lorenzoireyes-dot/Senior-Design-1-Washer-Mover/milestone_01_sensor_actuator/reports/README.md

# Milestone 01 Report

[View the original Group 18 Milestone 01 PDF](Milestone1_Group18%20(1).pdf).

The report documents the Arduino Mega and Simulink sensor and actuator experiments, measured signals, wiring and hardware images, and a SolidWorks design exercise. Figures are embedded in the report.
