lorenzoireyes-dot/Senior-Design-1-Washer-Mover/milestone_01_sensor_actuator/cad_documents/README.md

# Milestone 01 CAD Documentation

The milestone includes a SolidWorks golf ball shaped design with a debossed team number. Its image is included in the [original Milestone 01 report](../reports/Milestone1_Group18%20(1).pdf).

No standalone SolidWorks part or drawing has been uploaded to this directory. The report remains the available design evidence.
