lorenzoireyes-dot/Senior-Design-1-Washer-Mover/milestone_02_computer_vision/cad_documents/README.md

# Milestone 02 CAD Files

- [QuarterInchGameBoard.dwg](QuarterInchGameBoard.dwg): Game board drawing in DWG format.
- [QuarterInchGameBoard.stl](QuarterInchGameBoard.stl): Exported three dimensional geometry suitable for viewing in an STL compatible application.

These are uploaded design artifacts. Their presence does not establish that the game board has been fabricated or mechanically validated.
