lorenzoireyes-dot/Senior-Design-1-Washer-Mover/milestone_02_computer_vision/pictures/README.md

# Pictures

Upload photographs, screenshots, circuit images, plots, and other visual evidence for this milestone here. The original milestone report may also contain embedded figures.
