lorenzoireyes-dot/Senior-Design-1-Washer-Mover/milestone_01_sensor_actuator/reports/Milestone1_Group18 (1).pdf

# Milestone 1

# ECE 4950 Group 18

9/18/2026
Aden Casselman, Elijah Jarrett, Lorenzo Reyes,

# Skyler Beck, Tyler Burton

Executive Summary
Milestone 1 required our group to use MATLAB and Simulink with an Arduino controller, a potentiometer, and a servo motor to complete three tests involving sensor input and actuator control. The first test demonstrated the ability to receive an analog signal from the potentiometer and display the measured values as both numerical data and a plot in Simulink. The second test demonstrated our ability to turn the servo motor directly through commands issued in Simulink. The third test combined the sensor and actuator by using the potentiometer value to control the servo motor. When the potentiometer signal reached a specified threshold, the system changed the operating state of the servo motor. The threshold was adjustable so that the response of the system could be modified as needed.
In addition to the sensor and actuator testing, our group designed a small three-dimensional object for rapid prototyping. The part included our team number, Group 18, either embossed or debossed into the design and was designed to fit within the parameters: 4”x2”x1” (LxWxD). SolidWorks was used to create a three-dimensional model. Together, these activities introduced the group to sensor data acquisition, real time control using MATLAB and Simulink, Arduino hardware interfacing, and three-dimensional modeling for engineering applications.


Materials and Methods of the Sensor/Actuator Demonstration
Equipment and Software
Item | Manufacturer/ Model Version/ Rating | Purpose
Software | MATLAB/ Simulink | 2026a | Modeling data display and control
Micro Controller | Arduino Mega | 2560 | Sensor and actuator interface
Potentiometer | B103 | | Analog input sensor
Servo motor | MG92B | | Actuator
Hardware Configuration
To begin Lab 1, the Arduino Mega was connected to the potentiometer and servo motor using jumper wires and a breadboard, as shown in Figure 1. The potentiometer was connected to the 3.3 V supply, analog input A4, and ground. The servo motor was connected to the 5.5 V supply, digital PWM pin D2, and ground. All required power and ground connections were provided by the Arduino Mega.

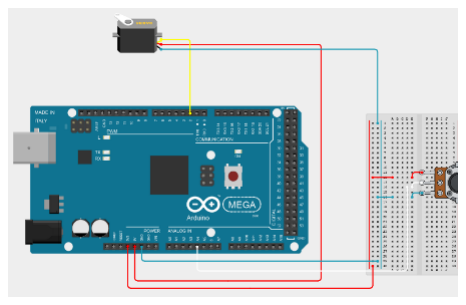
[picture p20: figure]
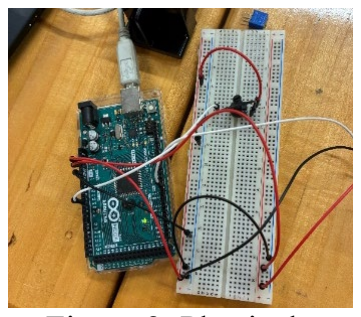
[picture p21: figure]

Figure 1. Circuit Diagram | Figure 2. Physical

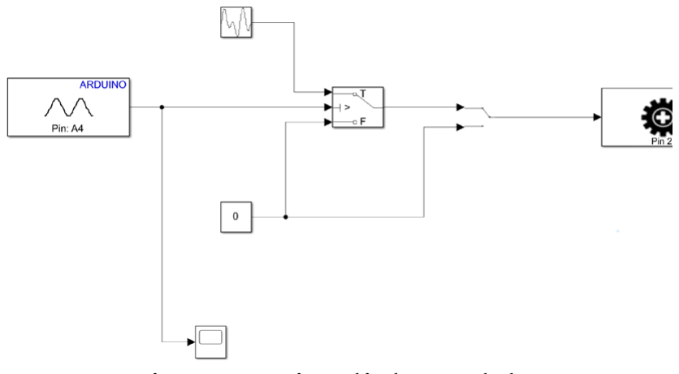
[picture p22: figure]

Circuit | Figure 3. Simulink Model
Software Configuration and Procedure
The host computer was configured with MATLAB and Simulink version 2026a, along with the required Arduino support package. The Arduino was connected to the host using USB on port COM3. The Simulink model was then configured to communicate with the Arduino hardware, as seen in Figure 3. Simulink Model. The servo motor was driven by a sine wave with an amplitude of 90 to produce continuous movement. The potentiometer signal was connected to a switch that monitored whether the input exceeded a specified threshold, after which the motor was turned off. A second switch was placed after the main switching logic to provide manual on and off control of the servo motor. Finally, a scope block was connected to the potentiometer signal to monitor and display the measured values.
Results and Discussion
The Simulink model shown in Figure 3 was used to conduct the three required sensor and actuator tests described in the Milestone 1 assignment [3]. The Arduino was operated using the Monitor and Tune function in Simulink, allowing the system to receive live potentiometer measurements and control the servo motor in real time [1]. The individual experiments and their results are organized below. Experiment 1: Potentiometer Signal Acquisition

Experiment 1 checked how well the system could read an analog signal from a potentiometer. To begin the potentiometer was linked to analog input A4 on the Arduino. The output from the potentiometer was watched in Simulink through a Scope block. When the potentiometer was turned to the right the reading went up. When it turned to the left the reading went down. These results showed that the Arduino and Simulink setup worked well. It was able to notice changes in where the potentiometer was and show the signal clearly.

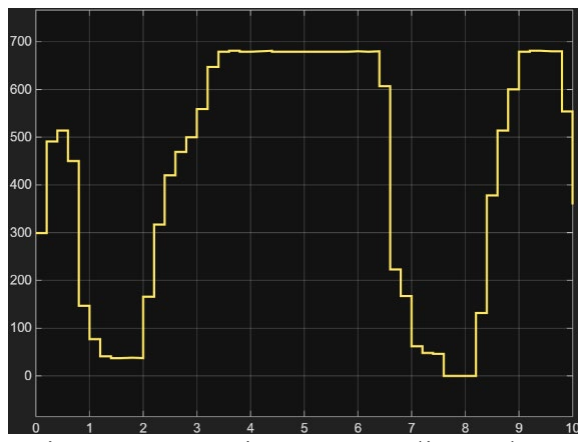
[picture p23: figure]
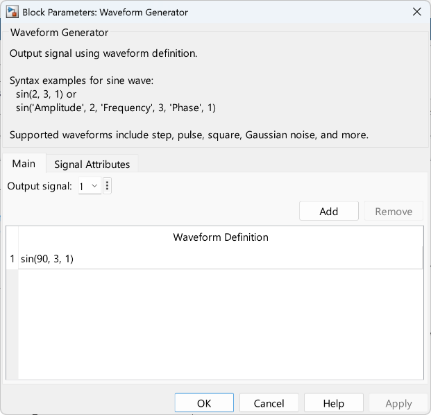
[picture p24: figure]

Figure 4. Potentiometer Readings Plot Figure 5. Sinewave Block Specifications

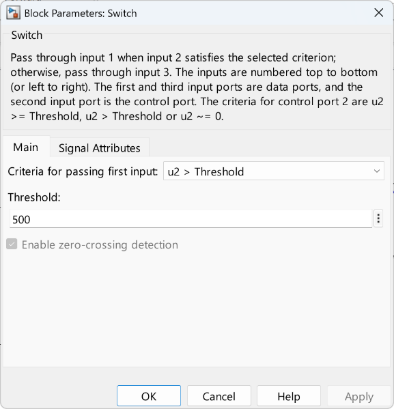
[picture p25: figure]

Figure 6. Threshold Block
Value
The potentiometer appeared to output a minimum value of 0 and a max value of just under 700. Experiment 2: Manual Servo Motor Control
The second experiment tested the ability to directly control the servo motor from Simulink. To achieve this, the Constant block in Simulink allowed the servo motor to receive a value from -90 to 90 to control the rotation speed. To change it to manual control, we utilized another switch to change the input to the servo to be the desired constant value.

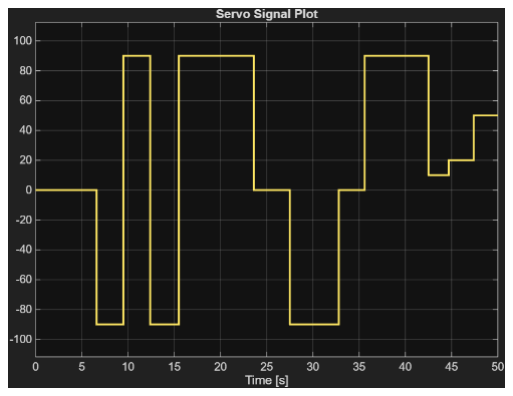
[picture p26: figure]

Figure 7. Manual Servo Control Plot Figure 7 shows the servo command during the manual control test. Changing the selected input caused the command sent to the servo motor to change between the active and inactive states. The servo responded to these changes as expected, demonstrating that its operation could be controlled directly through Simulink.
Experiment 3: Potentiometer Threshold Control

The third experiment combined the potentiometer input with the servo motor control logic. A threshold value of 500 was selected in the Simulink switch as shown in Figure 6. While the potentiometer reading remained on one side of the selected threshold, the servo continued operating. As the potentiometer was rotated counterclockwise and the measured value reached approximately 500, the switching logic changed the command to the servo and stopped the motor.

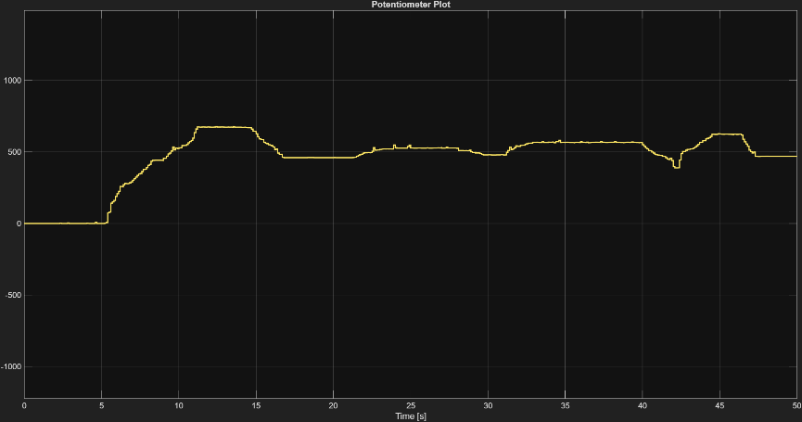
[picture p27: figure]
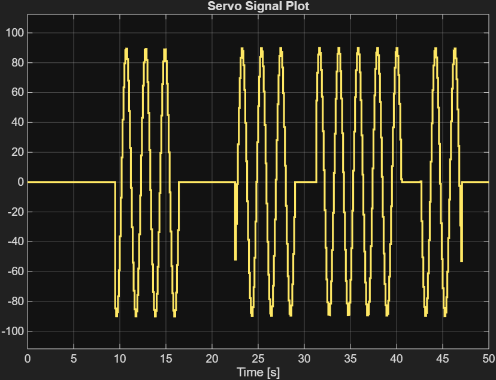
[picture p28: figure]

Figure 8. Potentiometer Waveform | Figure 9. Servo Waveform

Figures 8 and 9 show the potentiometer input and corresponding signal during the threshold control test. Before the threshold was reached, the servo remained at rest. Once the potentiometer signal reached approximately 500, the switching logic changed states, and the servo motor began to move, using a sine wave with amplitude 90 as the input. While the servo was deactivated, further decreases in the potentiometer value did not reactivate the servo. The experiment demonstrated that a variable sensor input could automatically control an actuator through Simulink.
3D Designed Part

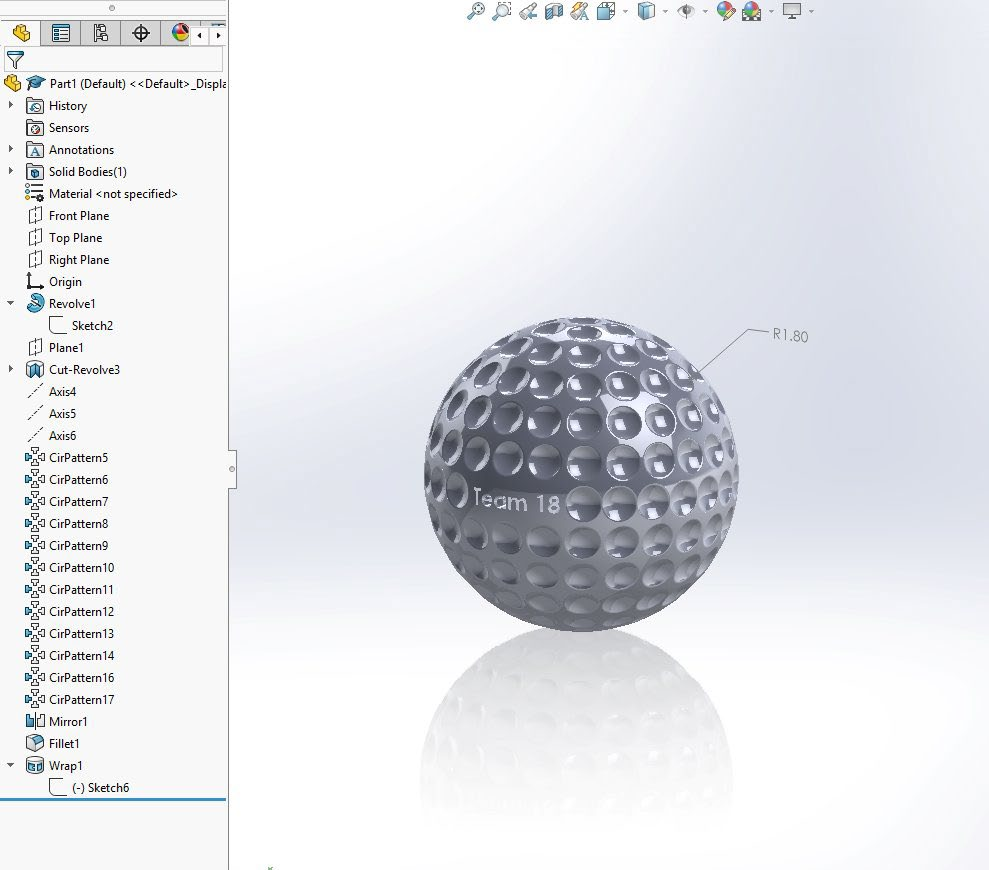
[picture p29: figure]

Figure10. Golf Ball Design Figure 10 shows the three-dimensional model created for Milestone 1. The design consists of a golf ball shaped object with “Team 18” debossed into its surface. The model was created as an introduction to CAD design and rapid prototyping and was designed to remain within the dimensional requirements specified for the milestone.

Conclusion
Based on the results of the Milestone 1 experiments, the Arduino Mega and MATLAB/Simulink environment provide a useful platform for developing and testing basic robotic control systems. The experiments demonstrated that the Arduino could receive sensor input from a potentiometer and use that input to control a servo motor through Simulink. However, the potentiometer introduced some limitations. The originally provided potentiometer was difficult to adjust consistently, and the B103 potentiometer produced readings that were somewhat imprecise and did not always reach the same maximum value. These inconsistencies could make repeatable control more difficult in applications that require precise sensor measurements.
Three-dimensional modeling and printing may also support the mechanical development of the project. SolidWorks was used during Milestone 1 to design a golf ball shaped object with “Team 18” debossed on its surface while remaining within the required dimensions of approximately 4 in × 2 in × 1 in. Similar 3D printed parts could later be used to create structural components such as mounts for lights, cameras, motors, or other project hardware. Possible applications currently being considered include an arm for supporting the electromagnet and a base for the motor used to rotate the provided plate.
This milestone also introduced the group to the software, hardware, and development processes that will be used throughout the project. In addition to gaining experience with Arduino hardware, MATLAB, Simulink, and three-dimensional modeling, the group established methods for collaboration by creating a group chat and a shared Google Drive for communicating, developing documents, and exchanging files. The Arduino Mega also has limitations that should be considered for more advanced robotic applications. Its physical size may be larger than necessary for compact systems, and other microcontrollers may provide better performance or efficiency depending on the final design requirements. Simulink provides a convenient graphical environment for developing and testing control logic, but model based or embedded code generation can introduce additional software and processing overhead compared with directly programming the microcontroller in languages such as C. Despite these limitations, the Arduino Mega provides an appropriate platform for the current project because it is accessible, relatively easy to configure, and capable of supporting the sensor and actuator control required at this stage of development. References
[1] MathWorks, “Getting Started with Arduino Hardware,” MATLAB and Simulink Support Package for Arduino Hardware. [Online]. Available: https://www.mathworks.com/help/supportpkg/arduino/ref/getting-started-with-arduino-hardware.html. (https://www.mathworks.com/help/supportpkg/arduino/ref/getting-started-with-arduino-hardware.html) [Accessed: Sep. 17, 2026].
[2] MathWorks, “Servo Control,” MATLAB and Simulink Support Package for Arduino Hardware. [Online]. Available: https://www.mathworks.com/help/supportpkg/arduino/ref/servo-control.html. (https://www.mathworks.com/help/supportpkg/arduino/ref/servo-control.html) [Accessed: Sep. 17, 2026].
[3] Clemson University, Holcombe Department of Electrical and Computer Engineering, “ECE 4950 Technical Milestone 1: Setting Up a Device to Receive and Transmit Data,” course handout, Fall 2026.

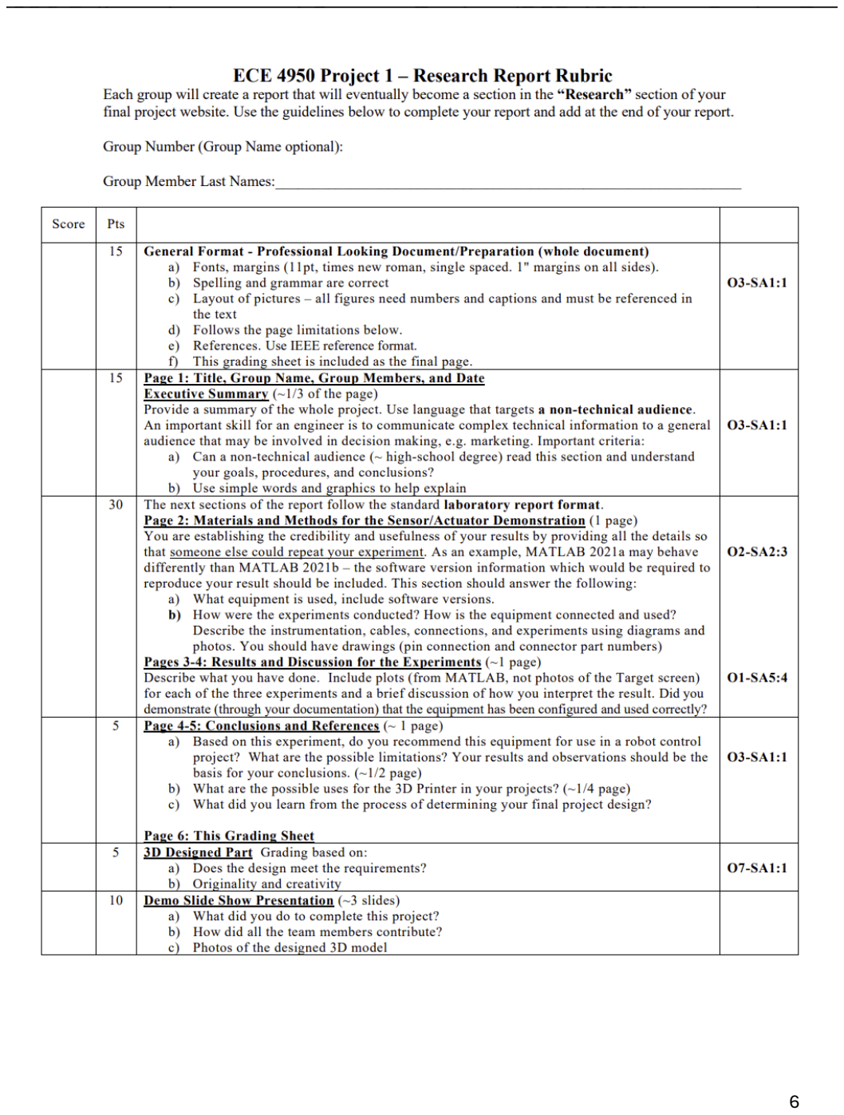
[picture p30: page 6]
