lorenzoireyes-dot/Senior-Design-1-Washer-Mover/milestone_01_sensor_actuator/pictures/circuit_design.png

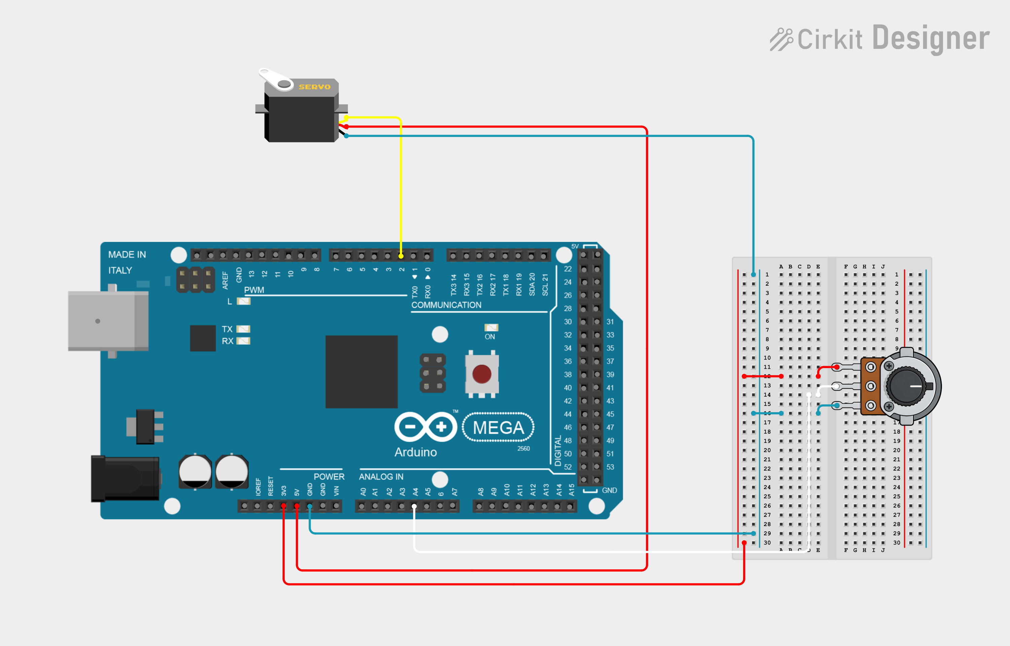
milestone_01_sensor_actuator/pictures/circuit_design.png
