lorenzoireyes-dot/Senior-Design-1-Washer-Mover/milestone_01_sensor_actuator/pictures/Potentiometer_Scope_Matlab.png

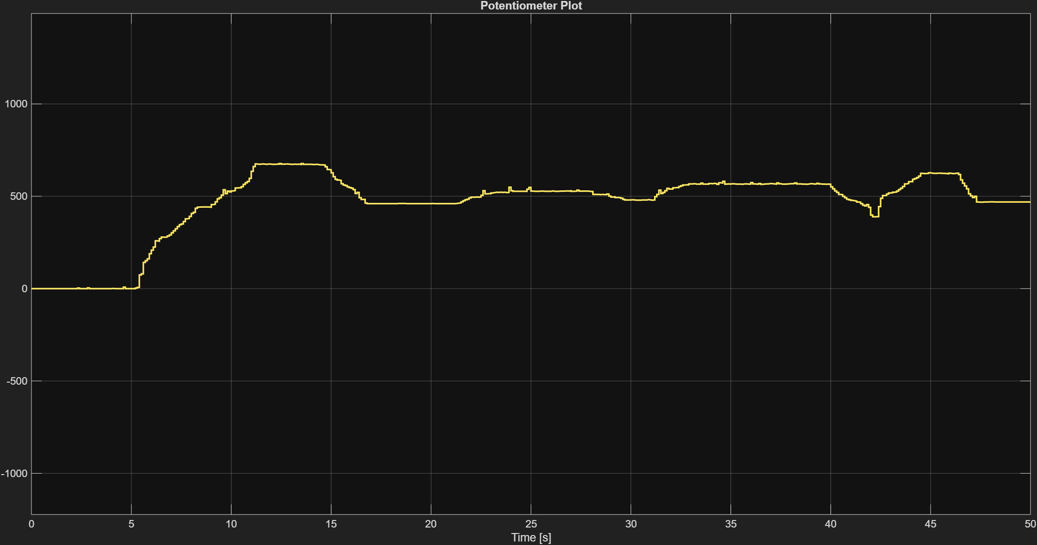
milestone_01_sensor_actuator/pictures/Potentiometer_Scope_Matlab.png
