lorenzoireyes-dot/Senior-Design-1-Washer-Mover/milestone_01_sensor_actuator/pictures/simulink_model.png

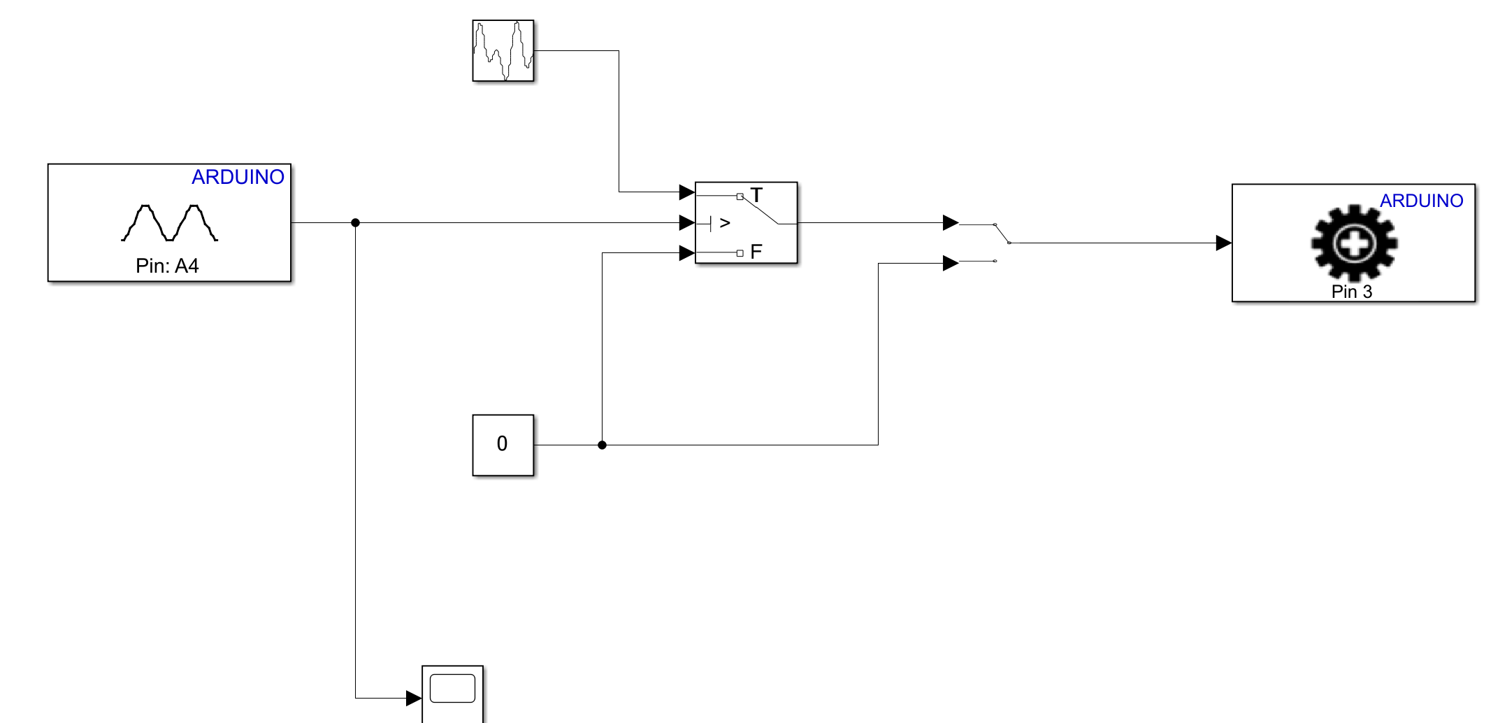
milestone_01_sensor_actuator/pictures/simulink_model.png
