lorenzoireyes-dot/Senior-Design-1-Washer-Mover/milestone_02_computer_vision/pictures/Brainstorming.jpg

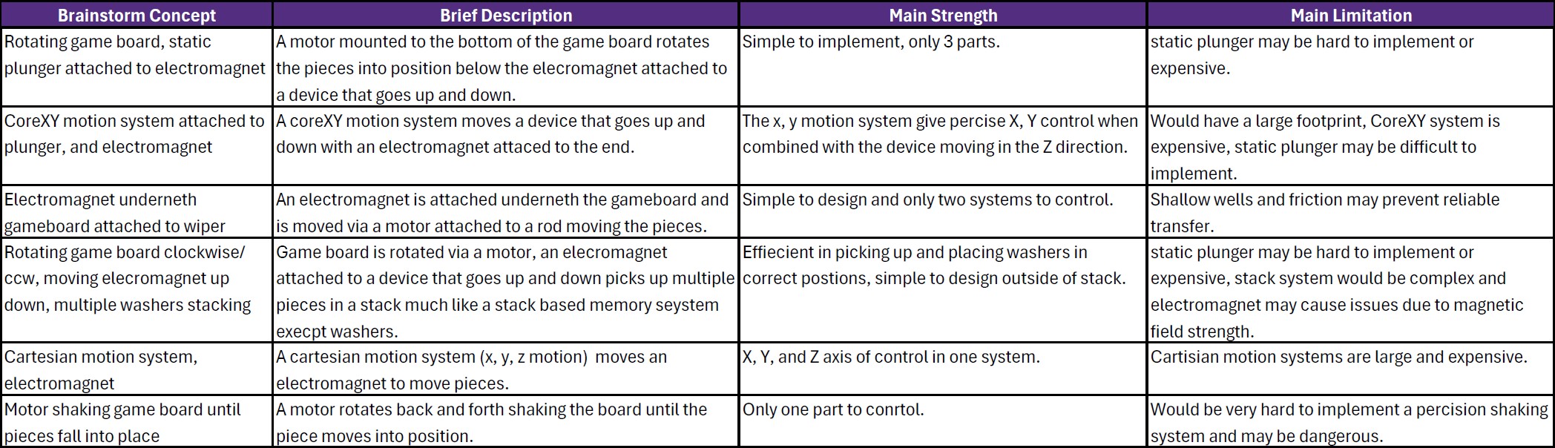
milestone_02_computer_vision/pictures/Brainstorming.jpg
