lorenzoireyes-dot/Senior-Design-1-Washer-Mover/milestone_03_control_subsystem/Pictures/gui_start_up.png

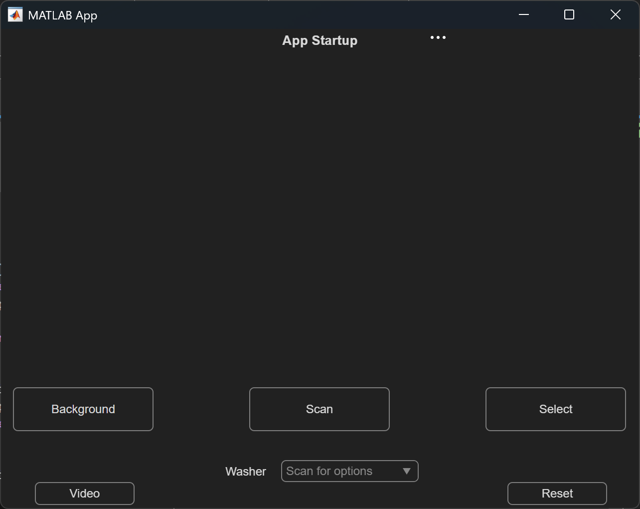
milestone_03_control_subsystem/Pictures/gui_start_up.png
