lorenzoireyes-dot/Senior-Design-1-Washer-Mover/milestone_03_control_subsystem/Pictures/main_circuit_diagram.png

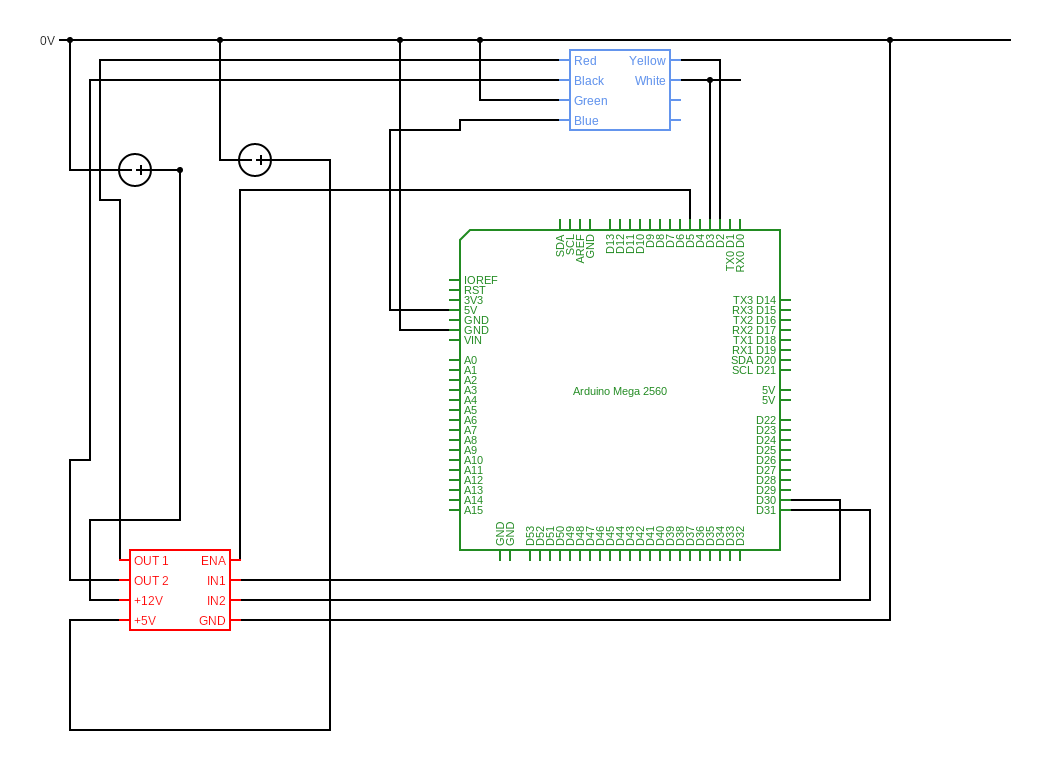
milestone_03_control_subsystem/Pictures/main_circuit_diagram.png
