lorenzoireyes-dot/Senior-Design-1-Washer-Mover/milestone_03_control_subsystem/Pictures/pid_controller_parameters.png

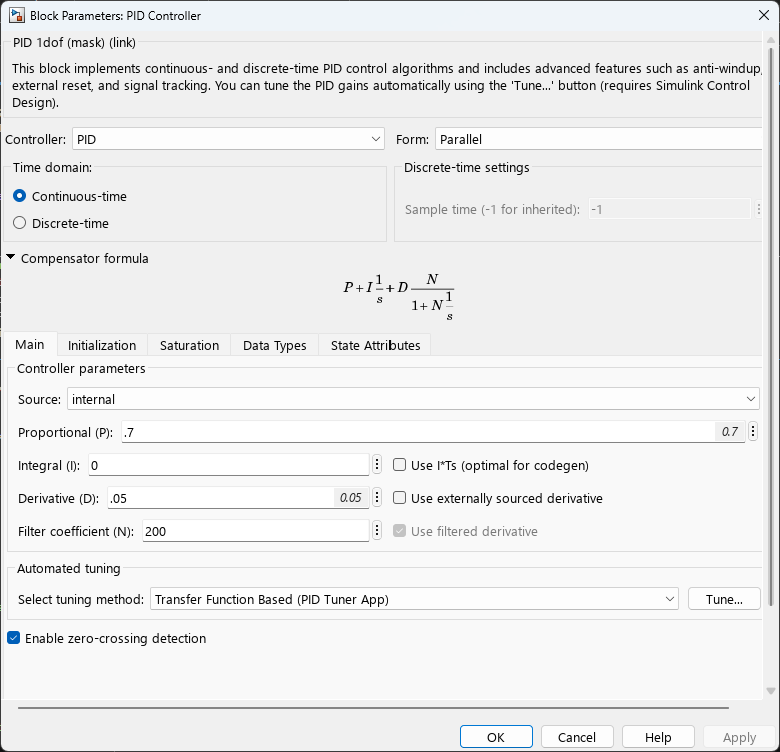
milestone_03_control_subsystem/Pictures/pid_controller_parameters.png
