lorenzoireyes-dot/Senior-Design-1-Washer-Mover/milestone_04/3d_print_files/SeniorDesign_motor&camholder_pic_MK1.png

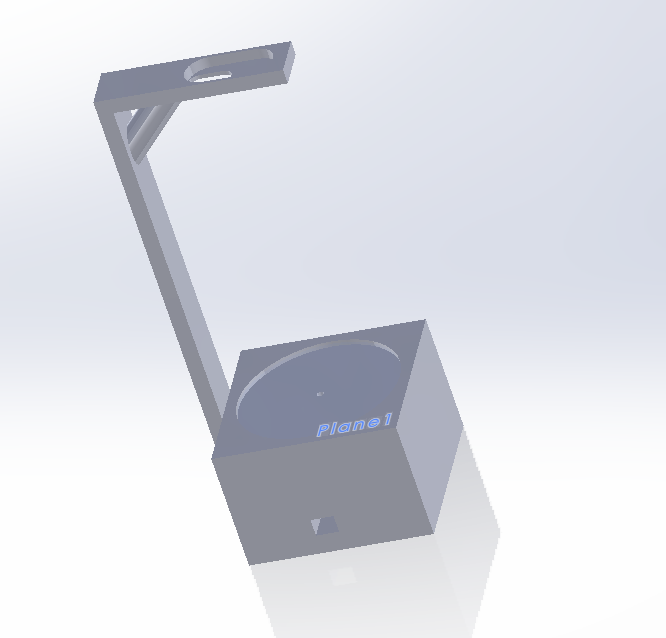
milestone_04/3d_print_files/SeniorDesign_motor&camholder_pic_MK1.png
