lorenzoireyes-dot/Senior-Design-1-Washer-Mover/milestone_04/pictures/81549947953__6C76B392-2490-4ACB-B350-8626EF937818.jpeg

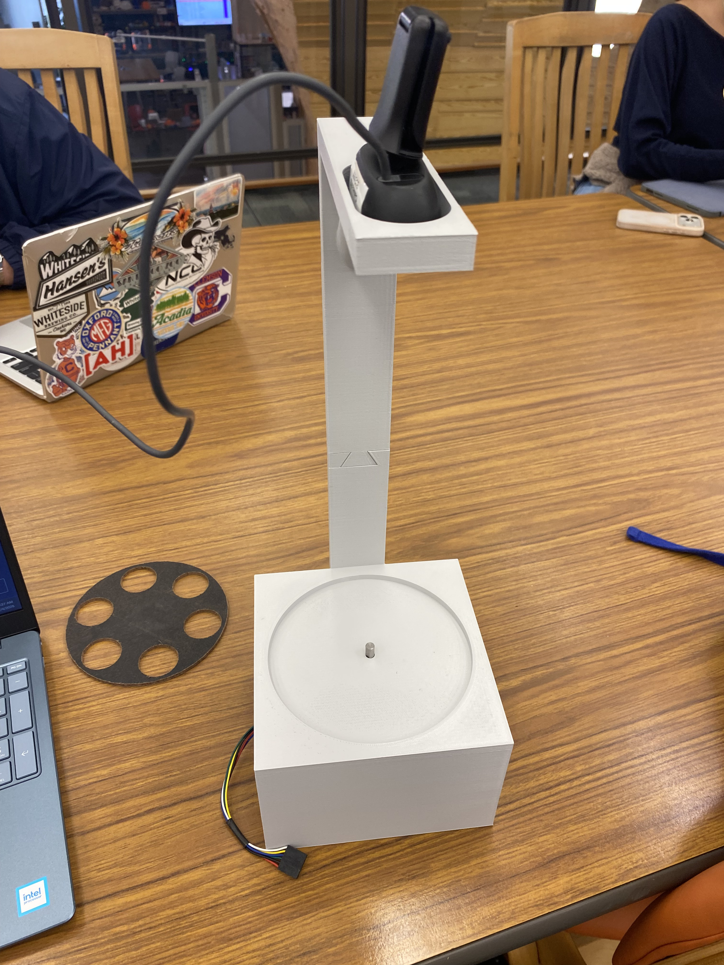
milestone_04/pictures/81549947953__6C76B392-2490-4ACB-B350-8626EF937818.jpeg
