lorenzoireyes-dot/Senior-Design-1-Washer-Mover/milestone_04/pictures/81549949920__01B4C5ED-BD7B-48AE-A90E-A4DA4E7EAEC7.jpeg

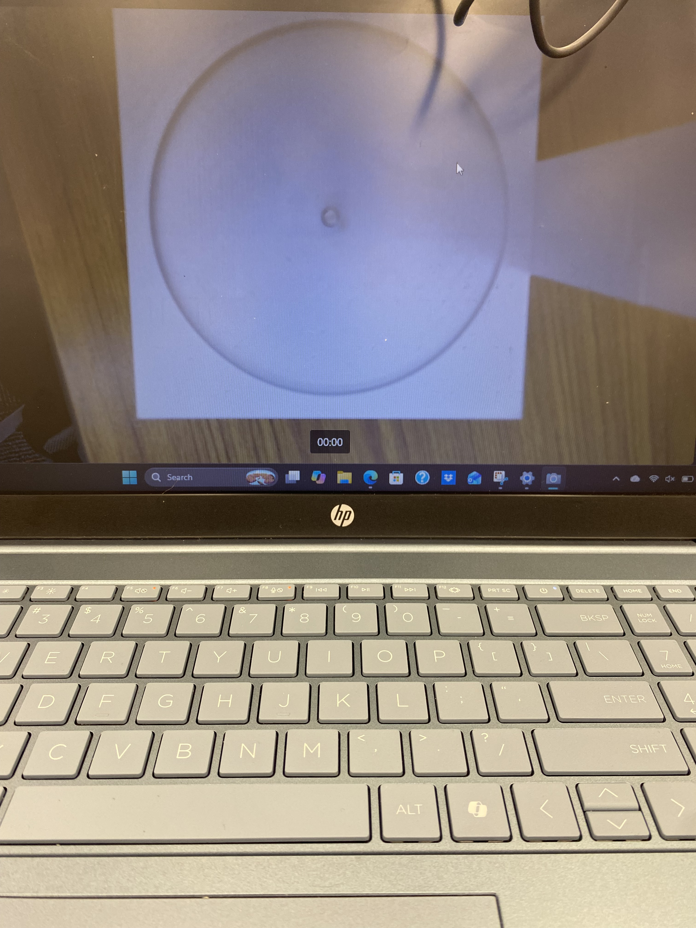
milestone_04/pictures/81549949920__01B4C5ED-BD7B-48AE-A90E-A4DA4E7EAEC7.jpeg
