lorenzoireyes-dot/Senior-Design-1-Washer-Mover/milestone_02_computer_vision/cad_documents/QuarterInchGameBoard.stl

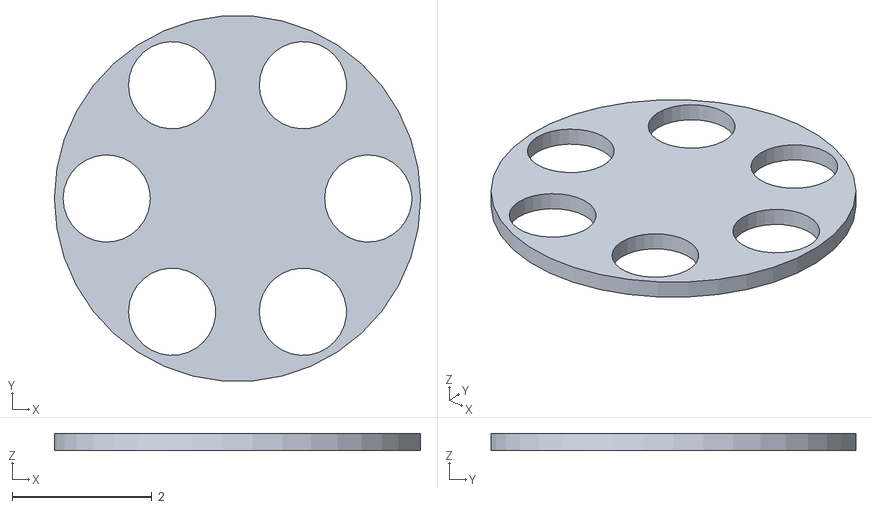
[picture p47: CAD file, 2026-10-17]
milestone_02_computer_vision/cad_documents/QuarterInchGameBoard.stl
5.25 x 5.23 x 0.25
