lorenzoireyes-dot/Senior-Design-1-Washer-Mover/milestone_04/3d_print_files/gameboard_holder.SLDPRT

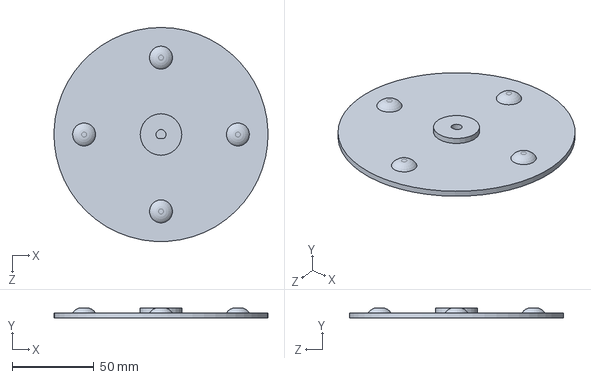
[picture p48: CAD file, 2026-11-06]
milestone_04/3d_print_files/gameboard_holder.SLDPRT
130.8 x 6.35 x 130.8 mm
