lorenzoireyes-dot/Senior-Design-1-Washer-Mover/milestone_04/3d_print_files/Servo_motor_attachment.SLDPRT

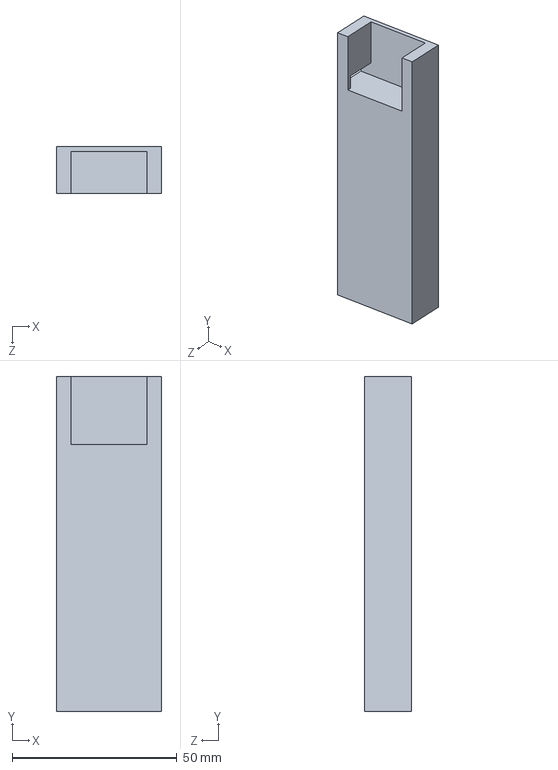
[picture p49: CAD file, 2026-11-06]
milestone_04/3d_print_files/Servo_motor_attachment.SLDPRT
31.8 x 101.6 x 14.3 mm
