lorenzoireyes-dot/Senior-Design-1-Washer-Mover/milestone_04/3d_print_files/SeniorDesign_motor&camholder_MK1.SLDPRT

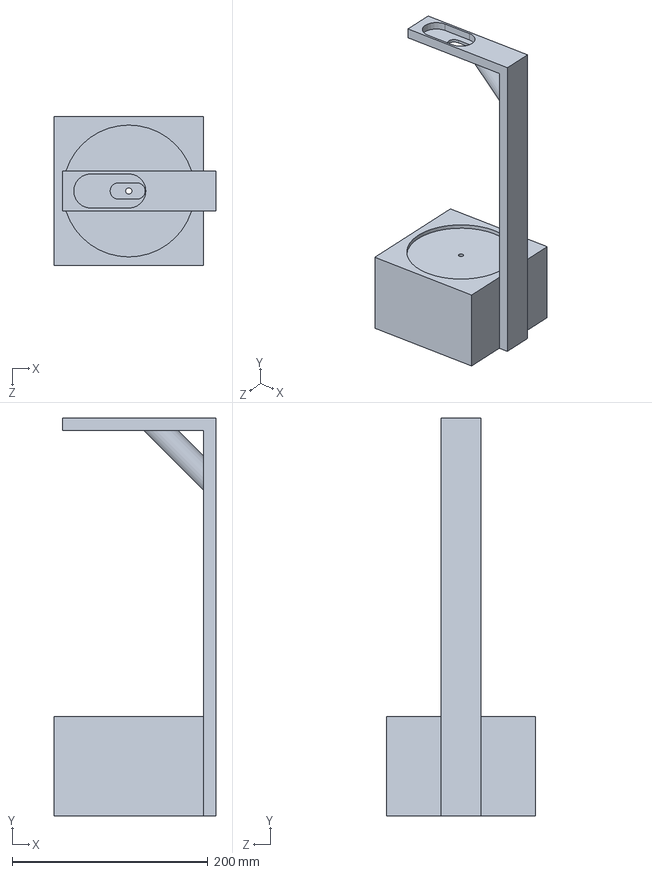
[picture p50: CAD file, 2026-11-04]
milestone_04/3d_print_files/SeniorDesign_motor&camholder_MK1.SLDPRT
165.1 x 406.4 x 152.4 mm
