lorenzoireyes-dot/Senior-Design-1-Washer-Mover/(list of files, cad)

Other CAD files:
milestone_02_computer_vision/cad_documents/QuarterInchGameBoard.dwg
milestone_04/3d_print_files/SeniorDesign_motor&camholder_MK1.STL
