lorenzoireyes-dot/Senior-Design-1-Washer-Mover/milestone_01_sensor_actuator/pictures/sine_wave_manual_scope.png

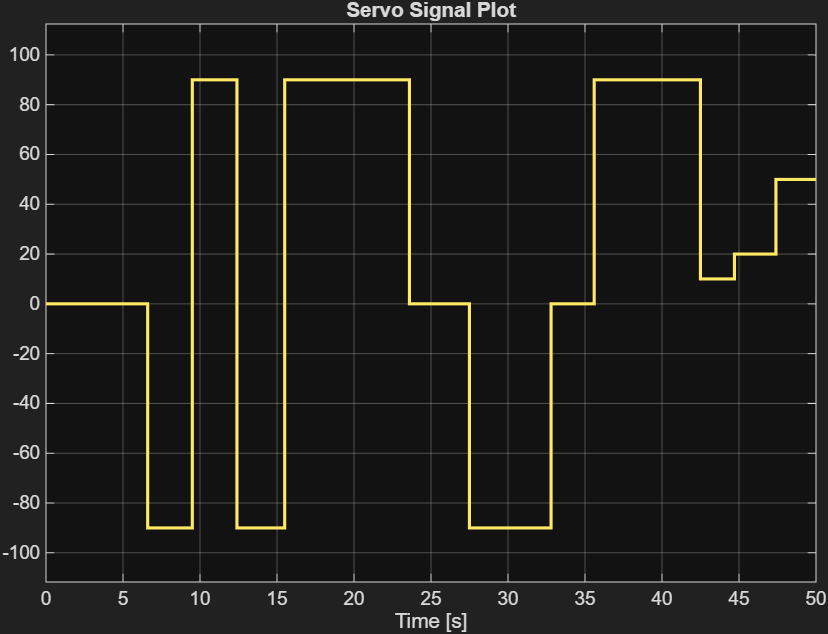
milestone_01_sensor_actuator/pictures/sine_wave_manual_scope.png
