lorenzoireyes-dot/Senior-Design-1-Washer-Mover/milestone_02_computer_vision/pictures/test_background_image.png

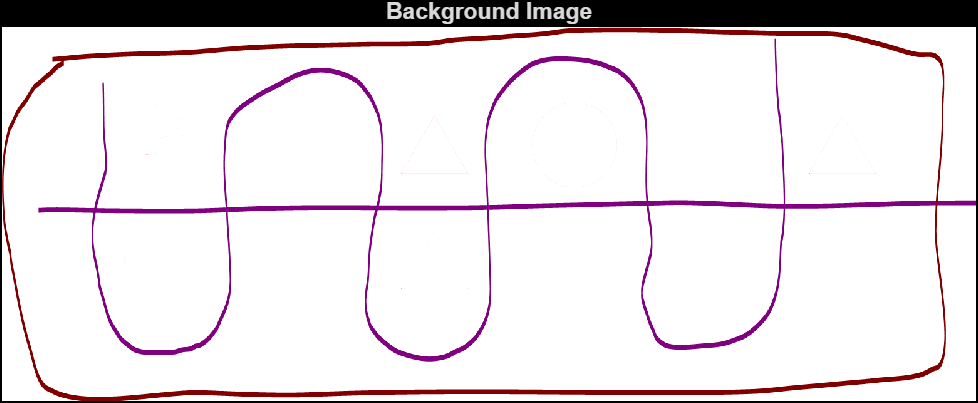
milestone_02_computer_vision/pictures/test_background_image.png
