lorenzoireyes-dot/Senior-Design-1-Washer-Mover/milestone_02_computer_vision/pictures/test_boards/game_board_test_set_Page_02.png

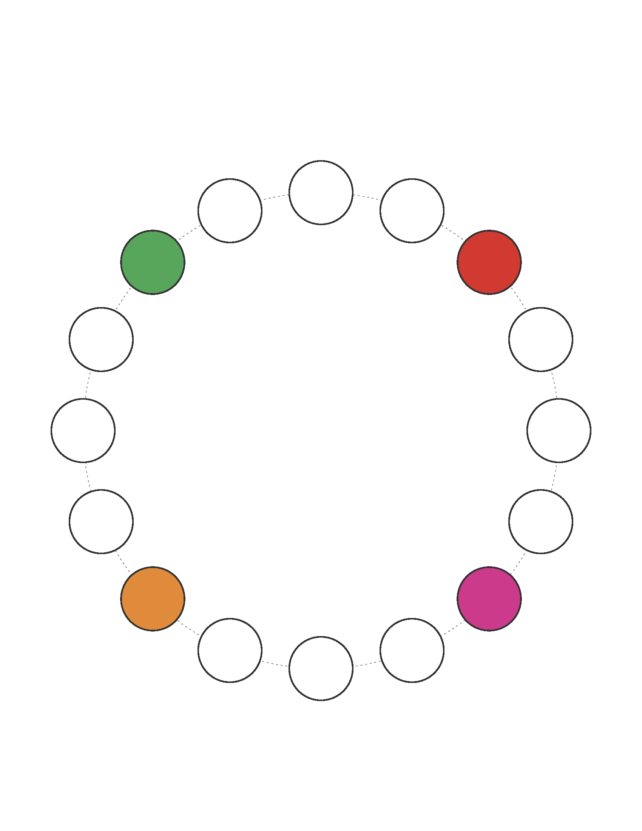
milestone_02_computer_vision/pictures/test_boards/game_board_test_set_Page_02.png
