lorenzoireyes-dot/Senior-Design-1-Washer-Mover/milestone_03_control_subsystem/Pictures/VisionSystemTest.JPG

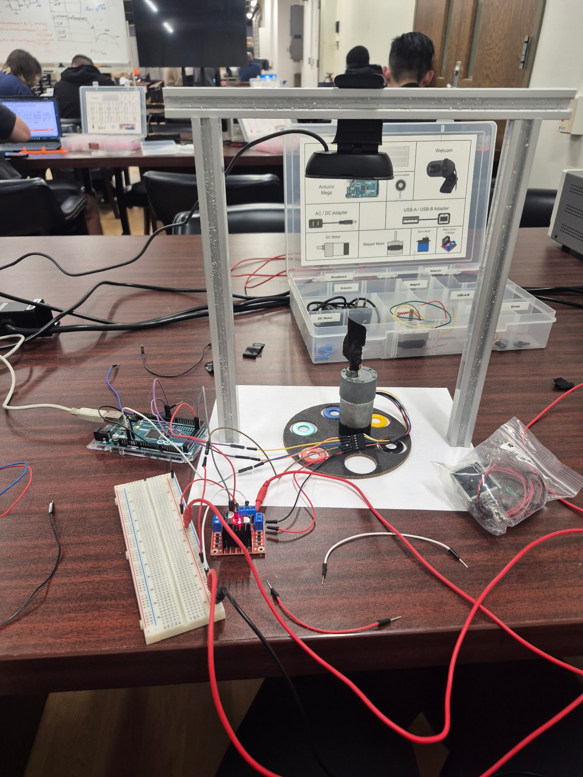
milestone_03_control_subsystem/Pictures/VisionSystemTest.JPG
