lorenzoireyes-dot/Senior-Design-1-Washer-Mover/milestone_03_control_subsystem/testing/Pictures/desired_position_fig.png

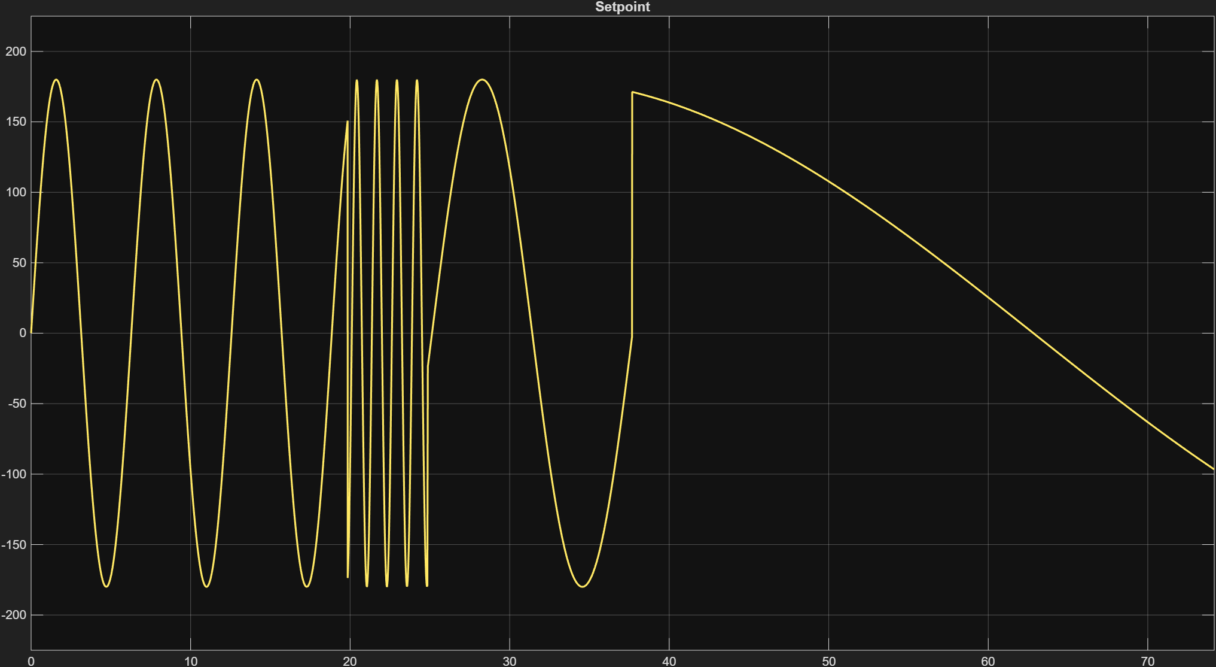
milestone_03_control_subsystem/testing/Pictures/desired_position_fig.png
