lorenzoireyes-dot/Senior-Design-1-Washer-Mover/milestone_03_control_subsystem/testing/Pictures/pre-tests_bg.png

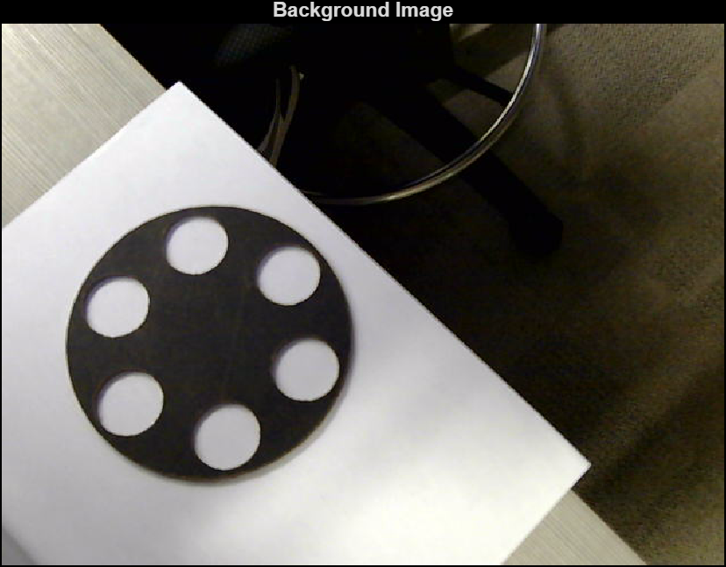
milestone_03_control_subsystem/testing/Pictures/pre-tests_bg.png
