lorenzoireyes-dot/Senior-Design-1-Washer-Mover/milestone_03_control_subsystem/testing/Pictures/test_calculated_diff.png

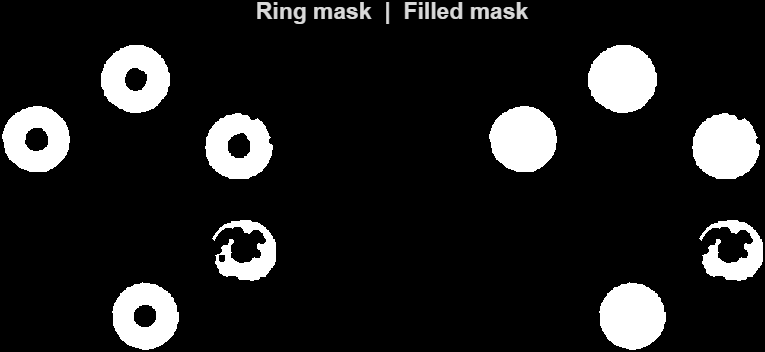
milestone_03_control_subsystem/testing/Pictures/test_calculated_diff.png
