lorenzoireyes-dot/Senior-Design-1-Washer-Mover/milestone_04/pictures/81533481124__99E2B38C-ED88-401E-8846-100BE3695CF4.jpeg

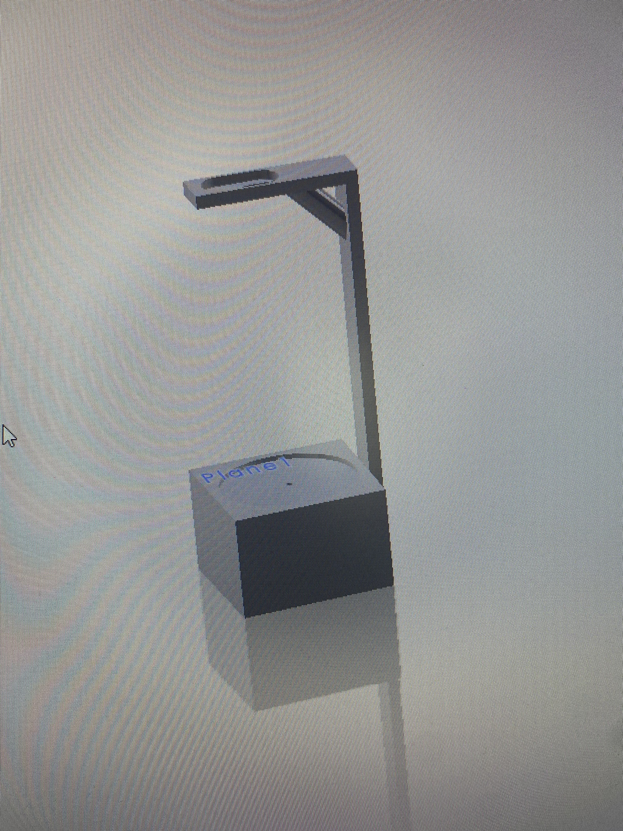
milestone_04/pictures/81533481124__99E2B38C-ED88-401E-8846-100BE3695CF4.jpeg
