lorenzoireyes-dot/Senior-Design-1-Washer-Mover/milestone_04/pictures/81533482925__A9DB9739-90D2-4091-9486-8F1DB50B2645.jpeg

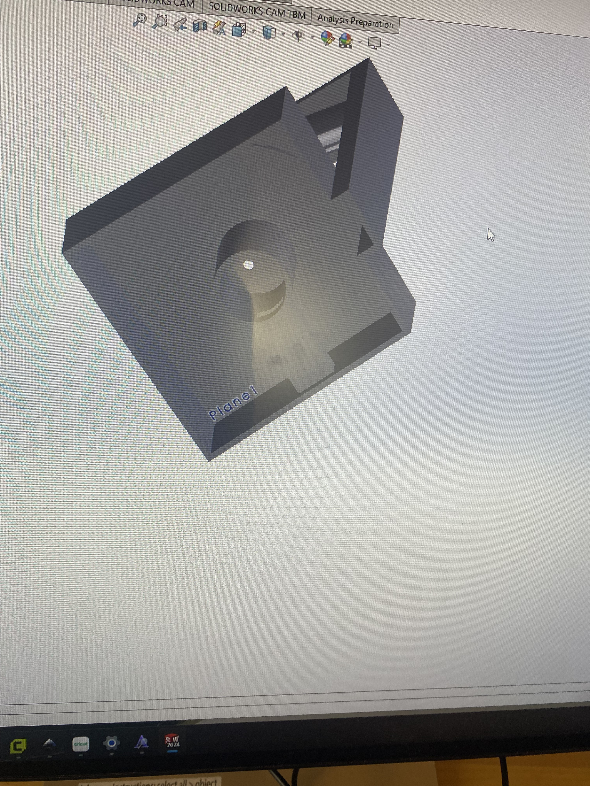
milestone_04/pictures/81533482925__A9DB9739-90D2-4091-9486-8F1DB50B2645.jpeg
